wdawson61/cattraxV2/rf/README.md

# rf

915 MHz collar dipole: antenna arm on the flex (x < 0) against the power arm/counterpoise (x > 20),
choked at x ≈ 60–64. See `docs/interface.md` and `docs/electrical.md`.

Put here: NEC models and sweeps, VNA captures (Touchstone `.s1p`), and a dated tuning log
(antenna copper length vs. resonance, measured on the cast band on the phantom, magnets in place).
