wdawson61/cattraxV2/tools/README.md

# tools

Helper scripts that don't belong to one domain. Planned:

- Hall sensor fitting calibration: read X with the clasp open and closed, store the midpoint
  threshold (`docs/checks/2026-11-12-hall-sensor.md` §5).
- Power budget (24 h) for the chosen cell.
- TTN payload formatter (uplink decoder).
