wdawson61/cattraxV2/datasheets/index.md

# Datasheets

PDFs live in the subfolders on each machine but are **not committed** (vendor copyright; see
`.gitignore`). This index is the record: add a row when you add a PDF, and note the revision the
design was checked against.

| Subsystem | Part | Document | Local file | Status |
|---|---|---|---|---|
| power | Nordic nPM1300 | Product specification | | **needed** |
| power | Grepow GRP751538 (440 mAh curved) | Cell spec, Rev A | `power/GRP751538-3.85V-440mAh.pdf` | have |
| power | Grepow GRP402425 (225 mAh curved) | Cell spec, Rev A (2019-07-31) | `power/GRP402425-3.8V-225mAh.pdf` | have |
| power | Cell protector IC (TBD) | Datasheet | | part not chosen |
| mcu | Nordic nRF54L10 | nRF54L15/L10/L05 product specification | | **needed** |
| radio | Semtech SX1262 | SX1261/2 datasheet | | **needed** |
| radio | Semtech | 915 MHz reference design | | **needed** |
| gnss | u-blox MIA-M10Q | Integration manual | | **needed** |
| gnss | u-blox M10 | SPG 5.10 interface description (UBX-21035062) | `gnss/u-blox-M10-SPG-5.10_InterfaceDescription_UBX-21035062.pdf` | have |
| gnss | u-blox MAX-M10S | Integration manual (UBX-20053088) — reference only, not the V2 module | `gnss/MAX-M10S_IntegrationManual_UBX-20053088.pdf` | have |
| sensors | ST LIS2DW12 | Datasheet | | **needed** |
| sensors | TI TMAG3001 | Datasheet SLYS053C | `sensors/tmag3001.pdf` | have |
| misc | TI TMUX1101 | Datasheet | | **needed** |
| misc | TI TPD1E10B06 | Datasheet | | **needed** |
| mech | K&J Magnetics B842-N52 | Product page / spec | | **needed** |
| mech | Smooth-On Dragon Skin 20 (or 10 NV) | Technical bulletin | | **needed** |
| mech | Mill-Max dock targets | Datasheet (part TBD) | | part not chosen |
