wdawson61/cattraxV2/electrical/flex/flex_strip.png

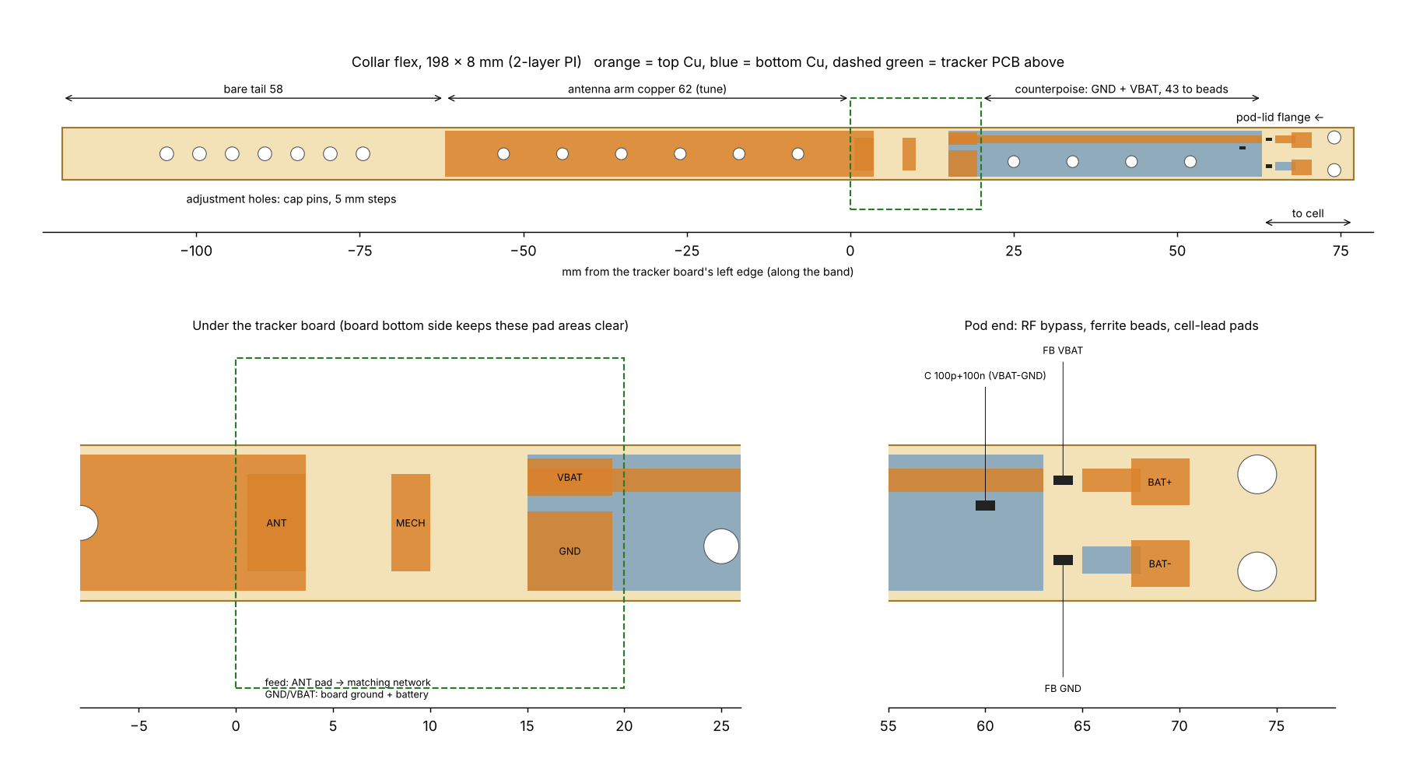
electrical/flex/flex_strip.png
