wdawson61/cattraxV2/mechanical/sheets/cap_screw_sections.png

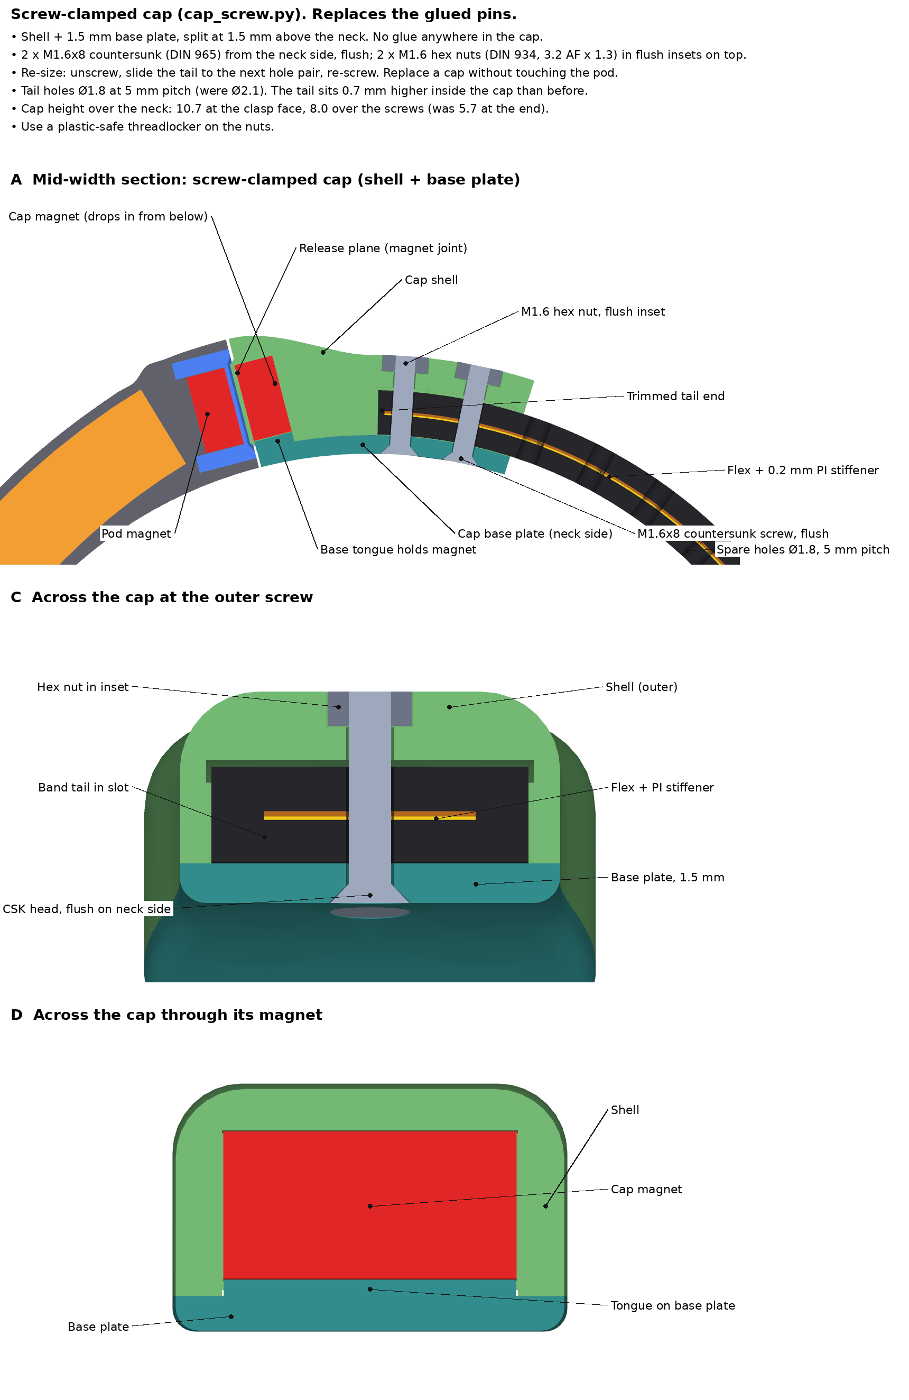
mechanical/sheets/cap_screw_sections.png
