wdawson61/cattraxV2/mechanical/sheets/clasp_sizing_sections.png

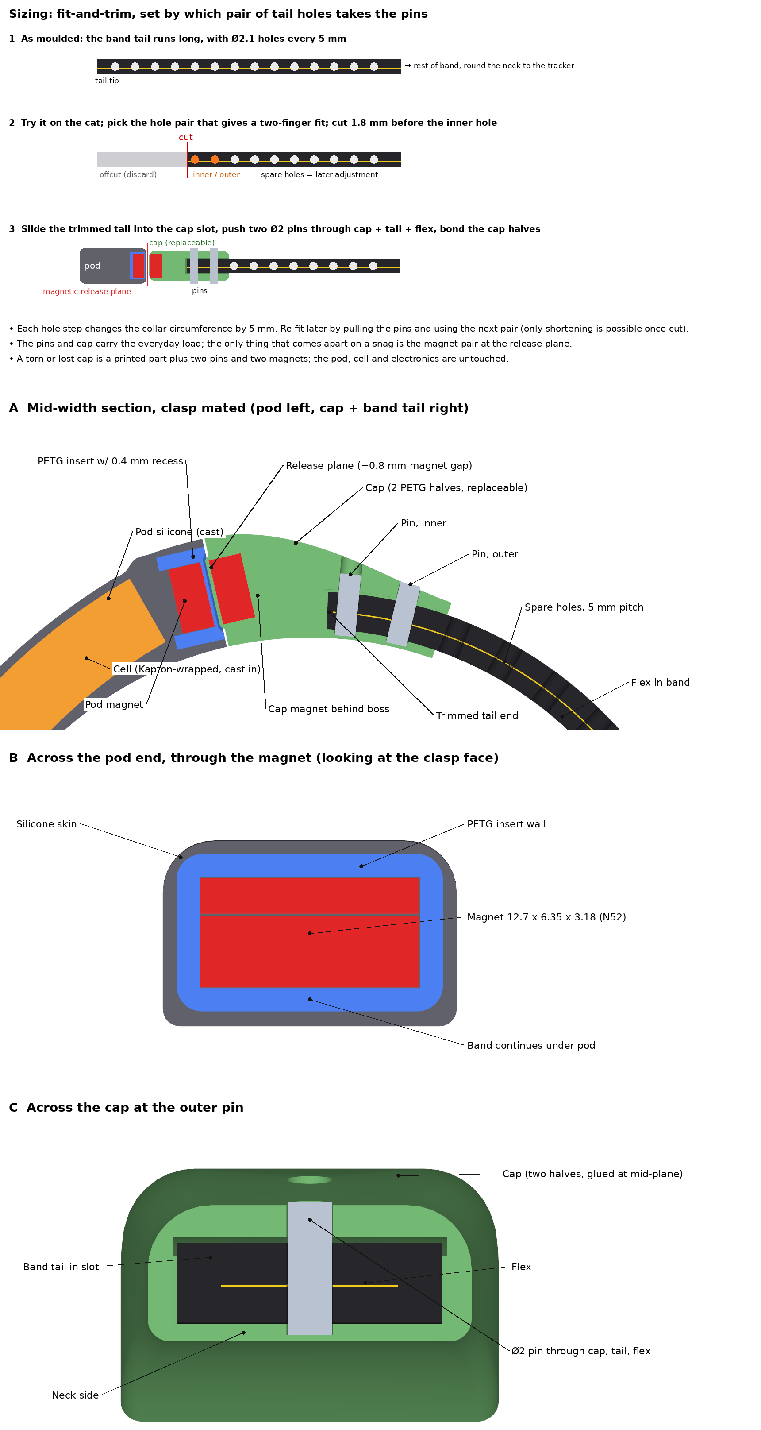
mechanical/sheets/clasp_sizing_sections.png
