wdawson61/cattraxV2/mechanical/sheets/hall_sensor_sections.png

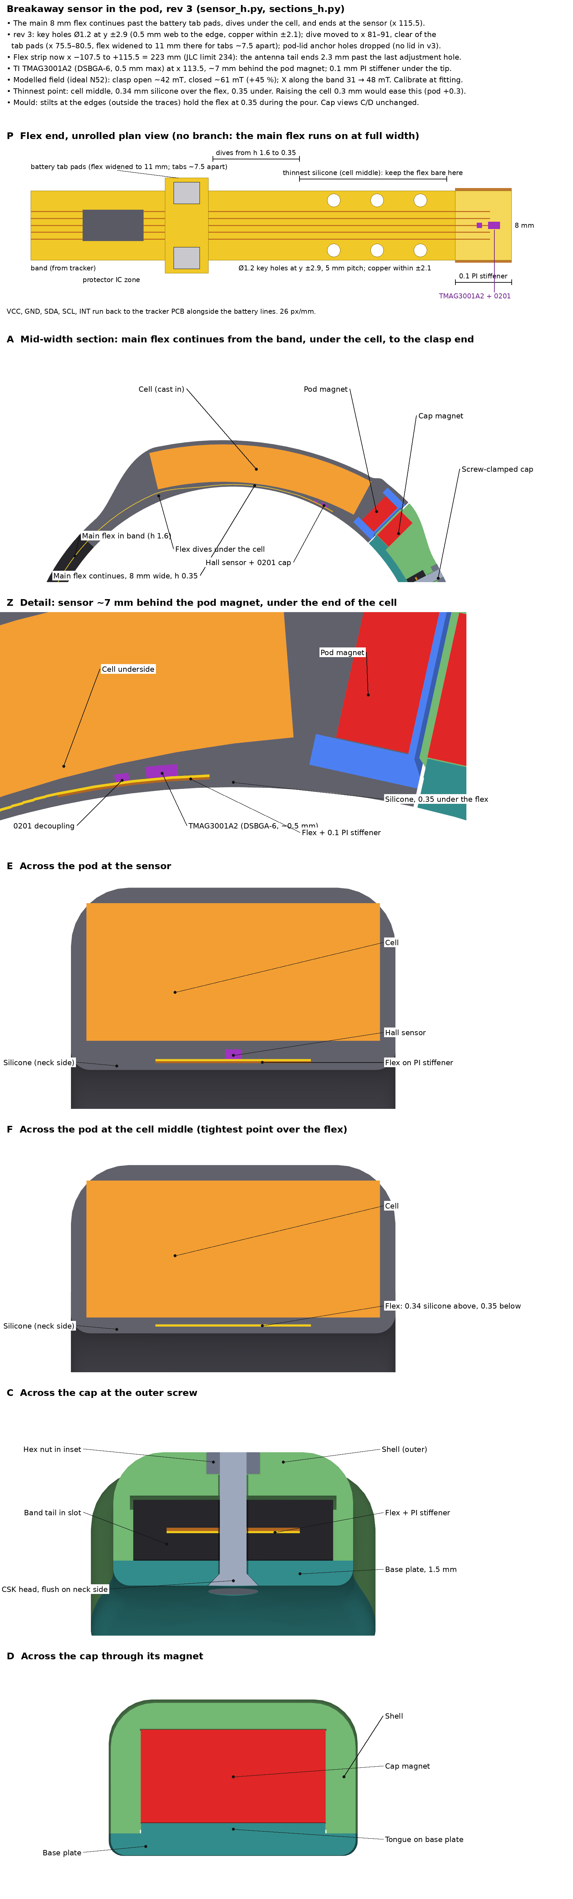
mechanical/sheets/hall_sensor_sections.png
