wdawson61/cattraxV2/mechanical/sheets/mould_v3_sheet.png

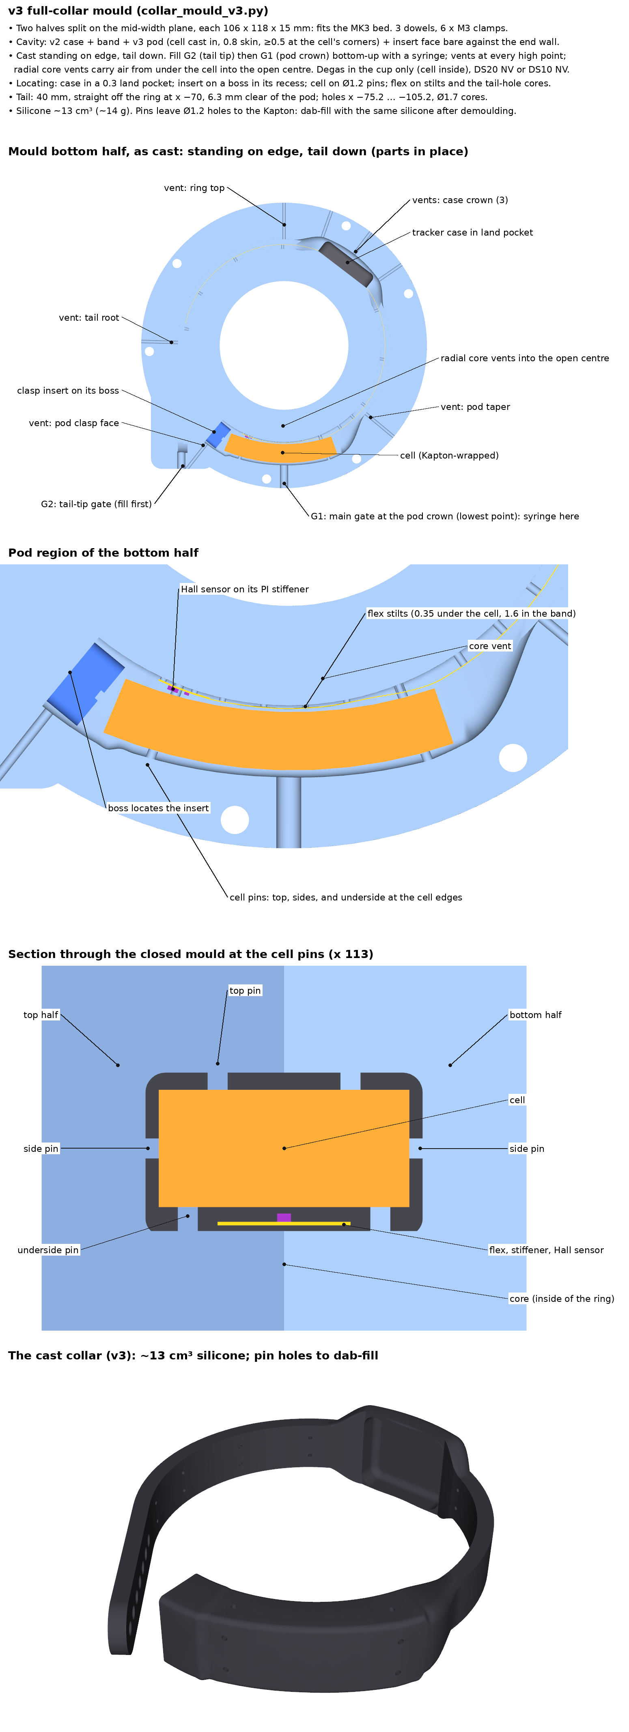
mechanical/sheets/mould_v3_sheet.png
