wdawson61/cattraxV2/mechanical/sheets/pod_v3_preview.png

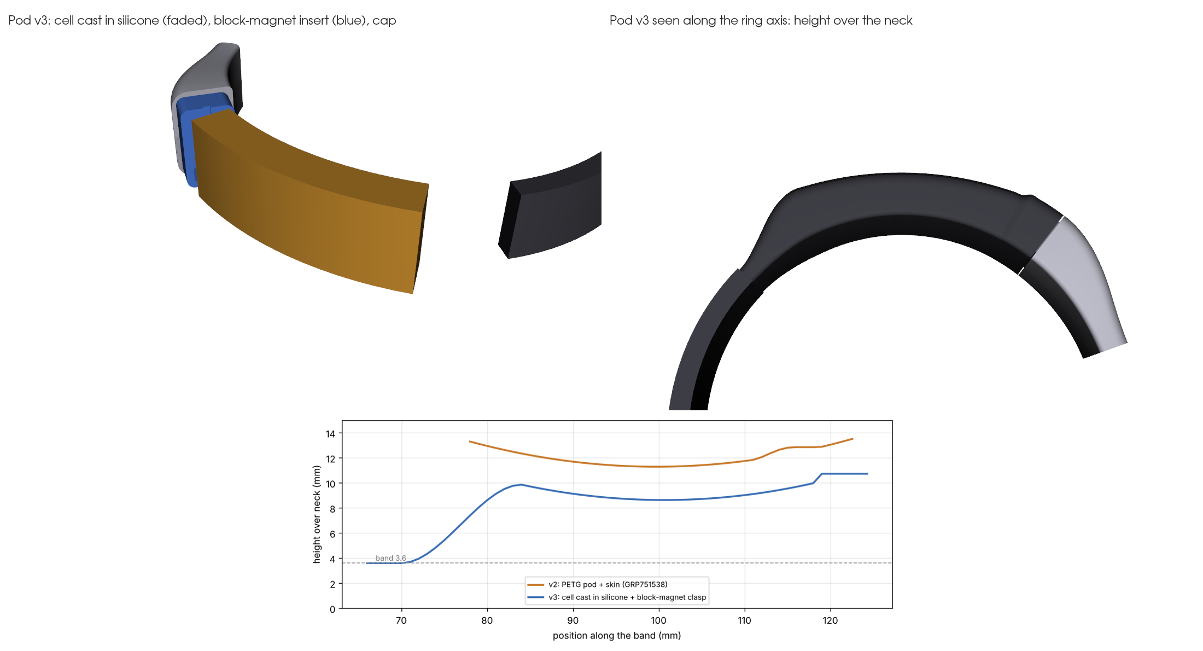
mechanical/sheets/pod_v3_preview.png
