wdawson61/cattraxV2/mechanical/sheets/v3_profile.png

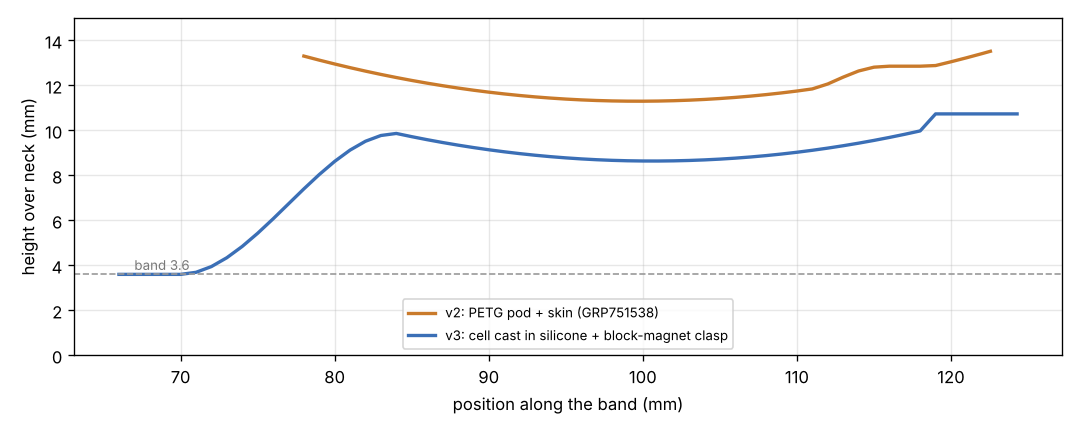
mechanical/sheets/v3_profile.png
