wdawson61/cattraxV2/electrical/flex/flex_strip.dxf

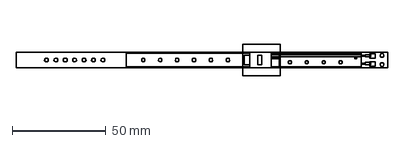
[picture p8: CAD file, 2026-11-12]
electrical/flex/flex_strip.dxf
197.5 x 17.0 mm
