wdawson61/cattraxV2/(commit log)

2026-11-12 cattraxV2: initial layout from the cattrax.6 respin work
    [connections_nrf54l10.csv, flex_strip.dxf]
2026-11-12 Add kicad_libs submodule
2026-11-12 Use kicad_lib2 as the KiCad library submodule
